eloisaglez/caelum/diseño/electrónica/circuit_image_pruebas.png

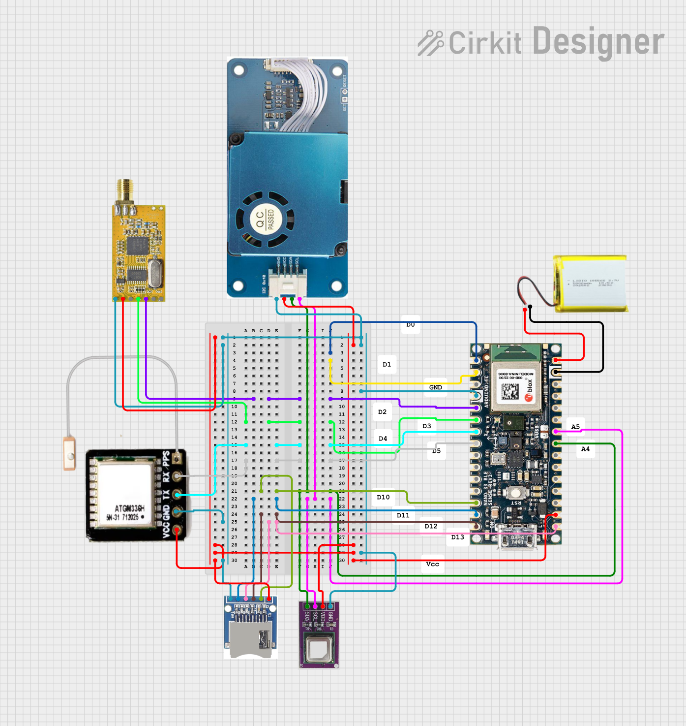
diseño/electrónica/circuit_image_pruebas.png
