eloisaglez/caelum/diseño/electrónica/circuit_image.png

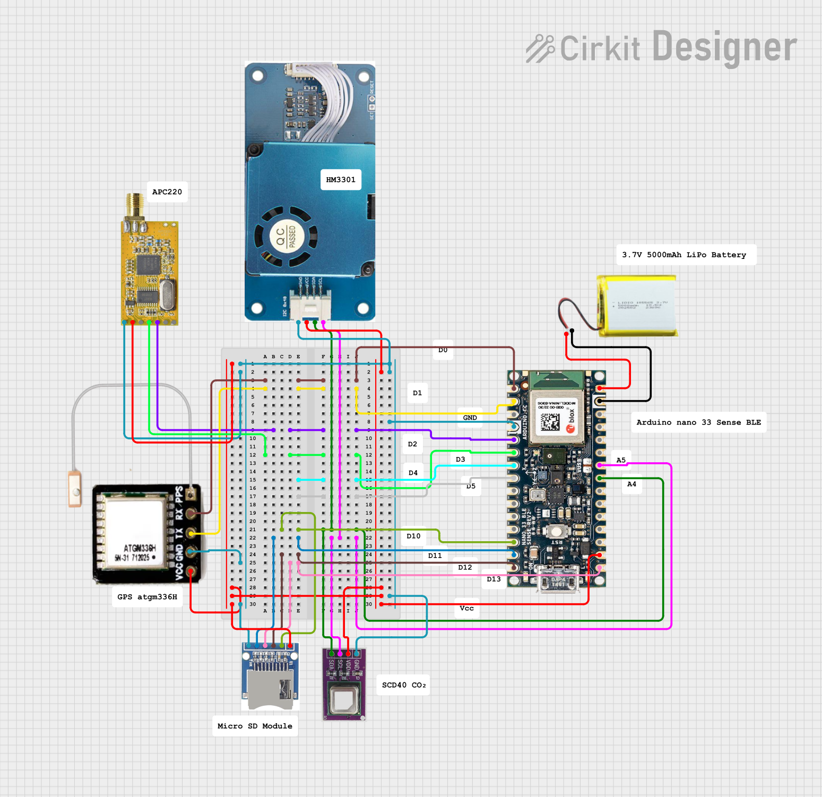
diseño/electrónica/circuit_image.png
