eloisaglez/caelum/README_main.md

# CanSat Misión 2 - Detección de Firmas de Combustión

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

---

## Descripción

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

---

## Características

| Componente | Descripción |
|---|---|
| **Microcontrolador** | Arduino Nano 33 BLE Sense Rev2 |
| **Sensor CO₂** | SCD40: CO₂ real (NDIR) + Temperatura + Humedad — trazador de estabilidad atmosférica |
| **Sensor Partículas** | HM3301: PM1.0, PM2.5, PM10 (láser) — perfil vertical e inversiones térmicas |
| **Temp/Humedad integrado** | HS300x + LPS22HB — validación cruzada triple de temperatura |
| **Posicionamiento** | GPS ATGM336H |
| **Almacenamiento** | MicroSD — CSV 27 columnas (respaldo local) |
| **Telemetría** | APC220: RF 434 MHz en tiempo real |
| **Panel Web** | Firebase + Telemetría en vivo |
| **Análisis** | Python: Perfiles verticales + Detección de inversiones + KML |

---

## Estructura del Repositorio

```
cansat-mision2/
│
├── design/                        
│   ├── structural/                  # Carcasa
│   ├── recovery/                    # Paracaídas
│   ├── electronics/                 # Circuitos
│   └── comms/                       # Antena
│
├── software/
│   ├── pruebas/                     # Programas individuales de cada sensor
│   │   ├── PROGRAMA_1_SENSORES_INTEGRADOS.ino
│   │   ├── PROGRAMA_2_SCD40_CO2.ino
│   │   ├── PROGRAMA_3_HM3301_PM25.ino
│   │   ├── PROGRAMA_4_GPS.ino
│   │   ├── PROGRAMA_5_MICROSD.ino
│   │   ├── PROGRAMA_6_APC220_CONFIG.ino
|   |   ├── PROGRAMA_7_GRABACION_RAM.ino
│   │   └── Otros
|   |
│   │
│   ├── vuelo/                       # Programa final + panel web
│   │   ├── CANSAT_VUELO_INTEGRADO.ino
│   │   └── panel_web/
│   │       ├── caelum_dashboard.html
│   │       ├── caelum_playback.py
│   │       └── receptor_telemetria.py
│   │
│   ├── post_vuelo/                  # Análisis después del vuelo
│   │   ├── analizar_vuelo.py
│   │   ├── generar_kml.py
│   │   ├── extraer_ram.py
│   │   ├── GUIA_POST_VUELO.md
│   │   ├── GUIA_RAPIDA_POST_VUELO.txt
│   │   └── README_post_vuelo.md
│   │
│   └── simulacion/                  # Simuladores pre-vuelo
│       ├── simulador_inversion_termica.py   # Escenario con inversión y PM2.5 alto
│       ├── simulador_sin_contaminacion.py   # Escenario limpio sin inversión
│       └── README_simulacion.md
│
├── documentation/
│   ├── pruebas/                     # Guías de cada sensor
│   │   ├── DOCUMENTO_1_SENSORES_INTEGRADOS.md
│   │   ├── DOCUMENTO_2_SCD40_CO2.md
│   │   ├── DOCUMENTO_3_HM3301_PM25.md
│   │   ├── DOCUMENTO_4_GPS.md
│   │   ├── DOCUMENTO_5_MICROSD.md
│   │   ├── DOCUMENTO_6_APC220_TELEMETRIA.md
│   │   └── DOCUMENTO_7_GRABACION_RAM.md
│   │
│   ├── vuelo/                       # Preparación del vuelo
│   │   ├── INDICE_DE_PRUEBAS_FINAL.md
│   │   ├── CHECKLIST_VUELO.md
│   │   └── IMPORTANTE_CAMBIO_FRECUENCIA.md
│   │
│   ├── troubleshooting/             # Solución de problemas
│   │   └── TROUBLESHOOTING_COMPLETO.md
│   │
│   └── INDEX.md
│
├── data/                            # Datos de vuelos; CSVs, Gráficas, mapas, KML 
│   ├── vuelos/                      
│   └── Simulación/                  # Datos generados con un Python 
│
└── README.md
```

---

## Inicio Rápido

### 1. Probar sensores integrados

```bash
1. Abrir: software/pruebas/PROGRAMA_1_SENSORES_INTEGRADOS.ino
2. Tools → Board → Arduino Nano 33 BLE
3. Ctrl+U para cargar
4. Monitor Serie a 9600 baud
```

### 2. Probar SCD40 (CO2)

```bash
1. Abrir: software/pruebas/PROGRAMA_2_SCD40_CO2.ino
2. Verificar conexión I2C (dirección 0x62)
3. Esperar 5 segundos para primera lectura
4. Monitor Serie: CO2 (ppm), Temp (°C), Humedad (%)
```

### 3. Probar HM3301 (PM2.5)

```bash
1. Abrir: software/pruebas/PROGRAMA_3_HM3301_PM25.ino
2. Verificar conexión I2C (dirección 0x40)
3. Esperar ~30 segundos para estabilización
4. Monitor Serie: PM1.0, PM2.5, PM10 (µg/m³)
```

### 4. Configurar telemetría APC220

```bash
1. Conectar APC220 a Arduino UNO (ver DOCUMENTO_6)
2. Cargar: software/pruebas/PROGRAMA_6_APC220_CONFIG.ino
3. En Monitor Serie escribir: WR 434000 3 9 3 0
4. Verificar con: RD
5. Repetir con el segundo APC220
```

### 5. Cargar programa final

```bash
1. Abrir: software/vuelo/CANSAT_VUELO_INTEGRADO.ino
2. Cargar en Arduino Nano 33 BLE
3. Verificar datos en receptor (USB-TTL + APC220)
```

### 6. Análisis post-vuelo

```bash
cd software/post_vuelo
pip install pandas numpy folium matplotlib
python limpiar_espera.py datos_SD_raw.csv   # Genera datos_SD.csv limpio
python analizar_vuelo.py datos_SD.csv
python generar_kml.py datos_SD.csv   # Genera trayectoria 3D para Google Earth
```

---

## Conexiones Hardware

### Arduino Nano 33 BLE Sense Rev2

```
Sensores Integrados:
├── HS300x:  Temperatura + Humedad               → temp_hs,  hum_hs  (sensor principal)
├── LPS22HB: Presión + Altitud + Temperatura     → presion, alt, temp_lps (validación T)
├── BMI270:  Acelerómetro + Giroscopio           → accel_x/y/z, gyro_x/y/z
└── BMM150:  Magnetómetro

Sensores Externos I2C (A4=SDA, A5=SCL):
├── SCD40 (0x62): CO₂ + Temperatura + Humedad   → co2, temp_scd, hum_scd (validación T+HR)
└── HM3301 (0x40): PM1.0, PM2.5, PM10           → pm1_0, pm2_5, pm10

Validación cruzada de temperatura: HS300x vs SCD40 vs LPS22HB
Validación cruzada de humedad:     HS300x vs SCD40

Comunicaciones:
├── Serial1 (Pin 0/1) → GPS ATGM336H
├── UART (Pin 2/3)    → APC220 (Telemetría)
└── SPI (D10-D13)     → MicroSD
```

### Pinout SCD40 (CO2)

```
VCC → 3.3V
GND → GND
SDA → Pin A4
SCL → Pin A5
```

### Pinout HM3301 (PM2.5)

```
VCC (rojo)     → 3.3V
GND (negro)    → GND
SDA (blanco)   → Pin A4
SCL (amarillo) → Pin A5
```

### Pinout GPS ATGM336H

```
TX GPS → Pin 0 (RX Serial1)
RX GPS → Pin 1 (TX Serial1)
VCC    → 3.3V
GND    → GND
```

### APC220 - Conexión Emisor (Nano 33 BLE)

```
TXD APC220 → Pin 2 (RX)
RXD APC220 → Pin 3 (TX)
VCC        → 3.3V
GND        → GND

Código: UART ApcSerial(3, 2);
```

### APC220 - Receptor en Tierra (USB-TTL)

```
USB-TTL     APC220
───────────────────
TX      →   TXD
RX      →   RXD
3.3V    →   VCC
GND     →   GND
```

---

## Interpretación de Datos

### CO₂ — Confirmación de sensor y atmósfera

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

### PM2.5 — Perfil vertical e inversiones térmicas (HM3301)

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

### Detección de inversiones térmicas

```
PATRÓN DE INVERSIÓN TÉRMICA (buscar en perfil vertical):
  Altitud ↑ + Temperatura ↑ (en vez de bajar) + PM2.5 ↑
                    ↓
       Capa de partículas atrapadas (no se dispersan)
                    ↓
       Al bajar la temperatura nocturna, la capa desciende
                    ↓
       Las partículas llegan a nivel del suelo
                    ↓
       Riesgo real: ataques de asma, alertas AQI en Madrid
```

### Validación cruzada de temperatura y humedad

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

---

## Firmas de Combustión Detectables

| Fuente | PM2.5 (µg/m³) | Patrón |
|---|---|---|
| **Aire limpio** | 0–12 | Constante y bajo |
| **Tráfico / zona urbana** | 12–55 | Aumenta en capas bajas |
| **Industria / incendio** | >55 | Picos en capas concretas |
| **Polvo (sin combustión)** | 50–150 | Solo PM alto, CO₂ constante |

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

```
CO₂ CONSTANTE + PM2.5 BAJO  → Aire limpio ✓
CO₂ CONSTANTE + PM2.5 ALTO  → Polvo o tráfico sin inversión
CO₂ VARIABLE  + PM2.5 ALTO  → Inversión térmica atrapando gases y partículas
CO₂ VARIABLE  + PM2.5 BAJO  → Capas diferenciadas sin fuente local

Nota: A ~1000m el CO₂ es siempre ~420 ppm. Lo relevante es si VARÍA con la altitud.
```

---

## Documentación

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

---

## Panel Web

Panel de telemetría en tiempo real conectado a Firebase.

**URL:** https://cansat-66d98.web.app

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

---

## Análisis Post-Vuelo

Scripts Python para analizar los datos después del vuelo.

**Ubicación:** `software/post_vuelo/`

**Fuentes de datos aceptadas:**

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

---

## Checklist Pre-Vuelo

```
[ ] Arduino inicializa correctamente
[ ] Todos los sensores responden:
    [ ] HS300x   (Temp/Hum integrado — valores coherentes con ambiente)
    [ ] LPS22HB  (Presión/Altitud/Temp integrado — altitud relativa = 0 m en tierra)
    [ ] BMI270/BMM150 (IMU integrado)
    [ ] SCD40    (CO₂ = 410–430 ppm en exterior — confirma mezcla correcta)
    [ ] HM3301   (PM2.5 < 35 µg/m³ en aire limpio)
[ ] Validación cruzada T+HR: DeltaT < 2 °C entre HS300x, SCD40 y LPS22HB
[ ] APC220 configurados (ambos: WR 434000 3 9 3 0)
[ ] GPS obtiene fix (4+ satélites)
[ ] MicroSD formateada (FAT32) y montada — CSV con 27 columnas
[ ] Batería cargada
[ ] Antenas conectadas en ambos APC220
[ ] Receptor en tierra funcionando
[ ] Panel web Firebase accesible
```

---

## Checklist Día del Concurso

```
[ ] Cambiar frecuencia APC220 según organización
[ ] Verificar comunicación emisor-receptor a distancia
[ ] Cargar CANSAT_VUELO_INTEGRADO.ino
[ ] Probar todos los sensores (valores baseline)
[ ] Verificar GPS en ubicación de lanzamiento
[ ] Comprobar que datos llegan a Firebase
[ ] ¡A volar!
```

---

## Librerías Necesarias

### Arduino IDE

**Sensores integrados:**
- Arduino_BMI270_BMM150 (IMU)
- Arduino_HS300x (Temperatura/Humedad)
- ReefwingLPS22HB (Presión/Altitud)

**Sensores externos:**
- SensirionI2CScd4x (SCD40 - CO2)
- Seeed_HM330X (HM3301 - PM2.5)

**Otros:**
- TinyGPSPlus (GPS)
- SD (MicroSD)

### Python

```bash
pip install pandas numpy folium matplotlib simplekml requests
```

---

## Troubleshooting Rápido

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

Ver: [TROUBLESHOOTING_COMPLETO.md](documentation/troubleshooting/TROUBLESHOOTING_COMPLETO.md)

---

## Notas Importantes

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

**MicroSD:**
- Solo 3.3V (NUNCA 5V)
- Formatear FAT32
- Máximo 32GB recomendado

**GPS:**
- Necesita cielo abierto
- Tiempo primera fix: 2-5 minutos

---

## Créditos

**IES Diego Velázquez**  
Departamento de Tecnología  
Torrelodones, Madrid, España

**Proyecto:** CanSat Misión 2 - Detección de Firmas de Combustión  
**Programa:** Erasmus+ STEMadrid Network  
**Fecha:** Febrero 2026

---

## Licencia

Uso educativo - IES Diego Velázquez

Este proyecto se desarrolla con fines educativos dentro del programa Erasmus+ y la red STEMadrid.

---

*Hecho con ❤️ para educación STEAM*

**#CanSat #STEAM #Arduino #AirQuality #CO2 #PM25**
