eloisaglez/caelum/documentacion/post-vuelo/GUIA_POST_VUELO.md

# GUÍA POST-VUELO — CanSat CAELUM
**IES Diego Velázquez · Misión 2 · Detección de Firmas de Combustión**

---

## Resumen del Sistema de Datos

El CanSat guarda los datos en **dos lugares simultáneamente**:

| Fuente | Dónde | Cuándo usar |
|---|---|---|
| **MicroSD** | Tarjeta SD dentro del CanSat | **Siempre** — fuente principal |
| **RAM backup** | Memoria interna del Arduino | Si la SD falla — fuente de emergencia |

> ⚠️ La RAM backup se pierde si se apaga el Arduino. La SD card conserva los datos aunque la batería se agote.

---

## 1. Recuperación del CanSat

### Pasos inmediatos al encontrarlo:

1. **No apagar el Arduino** — la RAM backup sigue activa
2. Comprobar que la batería tiene carga (LED verde encendido)
3. Llevar el portátil al lugar de recuperación si es posible
4. Si la batería está muy baja, **extraer la SD card primero**

---

## 2. Extraer Datos de la SD Card (Fuente Principal)

### Material necesario:
- Lector de tarjetas MicroSD (o adaptador SD)
- Ordenador

### Pasos:

1. **Apagar el CanSat** con seguridad (esperar a que el LED se apague)
2. **Extraer la MicroSD** del módulo Adafruit
3. **Insertar** en el lector de tarjetas del ordenador
4. Buscar el archivo **`VUELO.CSV`** en la raíz de la tarjeta
5. **Copiar** `VUELO.CSV` a tu ordenador
6. Renombrar para identificar el vuelo:
   ```
   VUELO.CSV → vuelo_brunete_17marzo.csv   (ejemplo)
   ```

### Verificar que el CSV es correcto:

Abrir en Excel o Google Sheets y comprobar:
- ✅ Primera fila es la cabecera con 25 columnas
- ✅ Los números tienen sentido (altitud entre 0–1100 m, CO₂ entre 400–600 ppm)
- ✅ El timestamp aumenta progresivamente
- ✅ La columna `fase` pasa por: `espera → caida_libre → apertura → descenso → tierra`

**Cabecera esperada (25 columnas):**
```
timestamp, datetime, lat, lon, alt, alt_mar, sats,
temp_hs, hum_hs, temp_scd, hum_scd, temp_lps, presion,
co2, pm1_0, pm2_5, pm10,
accel_x, accel_y, accel_z, gyro_x, gyro_y, gyro_z, fase
```

---

## 3. Extraer RAM Backup (Solo si la SD Falló)

Si `VUELO.CSV` no existe o está vacío, usar el backup de RAM.

### Material necesario:
- Cable USB
- Ordenador con Arduino IDE o PuTTY

### Pasos:

1. **Conectar** el CanSat al ordenador por USB (**sin apagarlo**)
2. **Abrir Arduino IDE** → Herramientas → Monitor Serie
3. **Configurar** a 115200 baud
4. **Escribir** `CSV_RAM` y pulsar Enter

   El Arduino responderá con algo así:
   ```
   --- CSV RAM: inicio ---
   t_ms,alt_m,co2_ppm,pm25,temp_hs,hum_hs,temp_scd,hum_scd,temp_lps,acX,acY,acZ,fase
   1000,950.2,421,6.1,5.8,68.2,5.9,67.0,6.2,0.02,-0.01,9.81,caida_libre
   2000,932.5,422,5.8,5.9,68.0,6.0,66.8,6.3,...
   ...
   --- FIN: 185 registros ---
   ```

5. **Seleccionar** todo el texto (desde la cabecera hasta `FIN`)
6. **Copiar** (Ctrl+C)
7. **Abrir Bloc de notas**, pegar y guardar como `vuelo_ram.csv`

> ⚠️ La RAM guarda ~350 muestras a 2 segundos/muestra (~11 min). Menos resolución que la SD (1 muestra/segundo) pero suficiente para el análisis científico.

> Para limpiar la RAM tras exportar: escribir `BORRAR_RAM` en el Monitor Serie.

---

## 4. Análisis de Datos

### Instalación de dependencias (solo la primera vez):

```bash
pip install pandas numpy folium matplotlib
```

### Preparar el entorno:

```bash
# Copiar el CSV a la carpeta del script
cp vuelo_brunete_17marzo.csv software/post_vuelo/python/

# Ir a la carpeta
cd software/post_vuelo/python/
```

### Ejecutar el análisis:

```bash
python analizar_vuelo_v4.py vuelo_brunete_17marzo.csv
```

El script genera automáticamente la carpeta `analisis_vuelo/` con:

```
analisis_vuelo/
├── graf_1_perfil_vertical.png      → Perfiles PM + CO₂ + temperatura por altitud
├── graf_2_inversiones_termicas.png → Detección de capas e inversiones
├── graf_3_validacion_cruzada.png   → Comparativa de los 3 sensores de temperatura
├── graf_4_mision_primaria.png      → Altitud, presión, velocidad, trayectoria GPS
├── mapa_vuelo.html                 → Mapa interactivo con trayectoria y PM2.5
└── informe_vuelo.txt               → Resumen estadístico completo
```

---

## 5. Reproducir el Vuelo en el Panel Web

Para ver los datos en el dashboard en tiempo real (modo replay):

1. Subir `caelum_datos_vuelo.csv` a Google Colab
2. Ejecutar `caelum_playback.py`
3. Abrir el dashboard: https://cansat-66d98.web.app
4. Seleccionar **REPLAY VUELO**

```bash
# En Colab o local
python caelum_playback.py caelum_datos_vuelo.csv
```

---

## 6. Interpretación de Resultados

### CO₂ — Trazador de estabilidad atmosférica

> El CO₂ a 1000 m **no indica calidad del aire** — indica si la atmósfera está bien mezclada.

| CO₂ vs Altitud | Interpretación |
|---|---|
| ~420 ppm constante en todo el perfil | ✅ Atmósfera bien mezclada — normal |
| Aumenta gradualmente al bajar | Fuentes de combustión en superficie (tráfico) |
| Pico en una altitud concreta | Posible capa de inversión atrapando gases |
| Variación > 20 ppm entre altitudes | Capas atmosféricas diferenciadas detectadas |

---

### PM2.5 — Perfil vertical e inversiones térmicas

| PM2.5 (µg/m³) | Calidad OMS | Causa probable |
|---|---|---|
| 0–12 | 🟢 Excelente | Aire limpio |
| 12–35 | 🟢 Buena | Zona urbana normal |
| 35–55 | 🟡 Moderada | Tráfico moderado |
| 55–150 | 🟠 Mala | Tráfico intenso, industria |
| >150 | 🔴 Muy Mala | Humo, incendio cercano |

**Patrón de inversión térmica** (buscar en `graf_2_inversiones_termicas.png`):
```
Altitud ↑ + Temperatura ↑ (en vez de bajar) + PM2.5 ↑
              ↓
  Capa de partículas atrapadas
              ↓
  Al bajar la temperatura nocturna, la capa desciende a nivel del suelo
              ↓
  Riesgo real: alertas AQI, ataques de asma en Madrid
```

---

### Validación cruzada de temperatura (graf_3)

Tres sensores miden temperatura de forma independiente:

| Sensor | Variable | Comportamiento esperado |
|---|---|---|
| HS300x | `temp_hs` | Referencia principal |
| SCD40 | `temp_scd` | Diferencia < 1 °C respecto a HS300x |
| LPS22HB | `temp_lps` | Puede leer +0.3–0.5 °C más por calor del procesador |

- **ΔT < 2 °C** entre HS300x y SCD40 → sensores funcionando correctamente
- **ΔT > 3 °C** → posible fallo de sensor o gradiente térmico real en el CanSat

---

### Firmas de combustión combinadas

```
CO₂ ALTO + PM2.5 ALTO  → Combustión activa (motor, fuego)
CO₂ ALTO + PM2.5 BAJO  → Fermentación/respiración (raro en exterior)
CO₂ BAJO + PM2.5 ALTO  → Polvo sin combustión (obra, viento)
CO₂ BAJO + PM2.5 BAJO  → Aire limpio ✓
```

---

## 7. Solución de Problemas

| Problema | Causa probable | Solución |
|---|---|---|
| `VUELO.CSV` no existe | SD no se inicializó | Usar RAM backup (`CSV_RAM`) |
| CSV con menos de 25 columnas | Versión antigua del firmware | Verificar que subiste `CANSAT_VUELO_INTEGRADO.ino` actualizado |
| CO₂ = 0 en todas las filas | SCD40 no respondió | Normal si el sensor tardó en calentarse. Las primeras 5s son 0 |
| GPS lat/lon = 0 | Sin fix GPS | Normal si el vuelo fue sin cielo despejado. Las gráficas funcionan sin GPS |
| `temp_lps` siempre ~0.5°C más alta | Calor del procesador | Normal y esperado — no es un error |
| ΔT > 3°C entre HS300x y SCD40 | Fallo de sensor o condensación | Revisar conexiones I2C del SCD40 |
| PM2.5 = 0 durante todo el vuelo | HM3301 no respondió | Verificar conexión I2C (0x40) y alimentación 3.3V |
| `analizar_vuelo_v4.py` da error | Columnas incorrectas | Verificar cabecera del CSV con Excel |

---

## 8. Comandos del CanSat (Monitor Serie a 115200 baud)

| Comando | Función |
|---|---|
| `CSV_RAM` | Exporta todos los datos guardados en RAM en formato CSV |
| `BORRAR_RAM` | Limpia la memoria RAM (hacer DESPUÉS de exportar) |

> La SD card se gestiona automáticamente — no necesita comandos.

---

## 9. Checklist Post-Vuelo

```
[ ] CanSat localizado y recuperado
[ ] Batería comprobada (LED verde)
[ ] Arduino NO apagado hasta exportar RAM si es necesario
[ ] SD card extraída
[ ] VUELO.CSV copiado al ordenador
[ ] VUELO.CSV verificado en Excel (25 columnas, datos coherentes)
[ ] Si SD vacía: RAM exportada con CSV_RAM y guardada
[ ] Script analizar_vuelo_v4.py ejecutado correctamente
[ ] graf_1_perfil_vertical.png revisada (¿hay capas de PM2.5?)
[ ] graf_2_inversiones_termicas.png revisada (¿hay inversión térmica?)
[ ] graf_3_validacion_cruzada.png revisada (ΔT < 2°C entre sensores)
[ ] mapa_vuelo.html abierto y trayectoria verificada
[ ] informe_vuelo.txt leído y guardado
[ ] Datos subidos a Firebase con caelum_playback.py (opcional)
[ ] Dashboard verificado en https://cansat-66d98.web.app
```

---

**Equipo:** CAELUM
**Centro:** IES Diego Velázquez
**Proyecto:** CanSat Misión 2 — Detección de Firmas de Combustión
**Fecha:** Febrero 2026
