eloisaglez/caelum/documentacion/Proyecto_Caelum_Guia_Completa_v2.docx

# PROYECTO CAELUM

Sistema de Telemetría GPS en Tiempo Real

Caelum - Del latín: Cielo, Firmamento

⚠️ NOTA IMPORTANTE — Documento de referencia histórica

Este documento describe la arquitectura inicial del proyecto (enero 2026), basada en Arduino Uno + GPS independiente. El sistema actual usa Arduino Nano 33 BLE Sense Rev2 con sensores SCD40, HM3301, LPS22HB, HS300x y GPS integrado.

Válido como referencia SOLO para la configuración de Firebase (Paso 1). Para la documentación técnica completa del sistema actual, consultar PRUEBAS_PROBLEMAS_SOLUCIONES_Arduino_Nano_33_BLE_Sense.md

## 📋 Introducción

Este documento contiene todos los pasos necesarios para configurar el sistema de telemetría en tiempo real del Proyecto Caelum. El sistema transmite datos GPS por radio APC220 y los visualiza en un panel web mediante Firebase Realtime Database.

## 🏗️ Arquitectura del Sistema

1. Caelum (Arduino + GPS ATGM336H + APC220)

Lee datos GPS y los transmite por radio

2. Estación Base (Arduino + APC220)

Recibe datos de Caelum y los reenvía al PC por USB

3. Script Python

Lee datos del puerto serie y los sube a Firebase

4. Firebase Realtime Database

Almacena y sincroniza datos en tiempo real

5. Panel Web (HTML + JavaScript)

Muestra datos en tiempo real: mapa, altitud, coordenadas, etc.

## 🔧 Hardware Necesario

### Para Caelum (Sonda)

- Arduino Uno (o compatible)
- GPS ATGM336H
- Módulo radio APC220 (transmisor)
- Alimentador 9V externo (IMPORTANTE: el GPS consume mucha corriente)
- Cables de conexión

### Para la Estación Base

- Arduino Uno
- Módulo radio APC220 (receptor)
- Cable USB para conexión al PC

## 🔥 Paso 1: Configuración de Firebase

6. Crear proyecto Firebase
- Ve a: https://console.firebase.google.com/
- Haz clic en 'Agregar proyecto'
- Nombre del proyecto: 'Caelum' (o el que prefieras)
- Desactiva Google Analytics (no es necesario)
- Haz clic en 'Crear proyecto'
7. Crear Realtime Database
- En el menú lateral: 'Realtime Database'
- Haz clic en 'Crear base de datos'
- Ubicación: 'europe-west1' (más cercana a España)
- Modo: 'Comenzar en modo de prueba' (temporal para desarrollo)
8. Obtener credenciales para Python
- Ve a: Configuración del proyecto (⚙️) → Cuentas de servicio
- Haz clic en 'Generar nueva clave privada'
- Se descarga 'serviceAccountKey.json' → Guárdalo en carpeta del proyecto
- ⚠️ IMPORTANTE: No subas este archivo a GitHub (es confidencial)
9. Obtener configuración Web
- Ve a: Configuración del proyecto → General
- En 'Tus aplicaciones' → Web (ícono </>) → Registrar app
- Nombre: 'Panel Caelum'
- Copia la configuración firebaseConfig (la necesitarás para el panel web)

## 💻 Paso 2: Código Arduino Caelum (Transmisor)

### Conexiones Hardware

Módulo | Pin Módulo | Pin Arduino
GPS ATGM336H | TX | Pin 4 (RX SoftwareSerial)
| RX | Pin 3 (TX SoftwareSerial)
| VCC | 5V
| GND | GND
APC220 | TXD | Pin 10 (RX SoftwareSerial)
| RXD | Pin 11 (TX SoftwareSerial)
| VCC | 5V
| GND | GND

### Código Arduino

Archivo: caelum_transmisor.ino

#include <TinyGPSPlus.h>
#include <SoftwareSerial.h>

// GPS
SoftwareSerial gpsSerial(4, 3);
TinyGPSPlus gps;

// APC220
SoftwareSerial radioSerial(10, 11);

void setup() {
gpsSerial.begin(9600);
radioSerial.begin(9600);
}

void loop() {
while (gpsSerial.available() > 0) {
if (gps.encode(gpsSerial.read())) {
if (gps.location.isUpdated()) {
radioSerial.print(gps.location.lat(), 6);
radioSerial.print(",");
radioSerial.print(gps.location.lng(), 6);
radioSerial.print(",");
radioSerial.print(gps.altitude.meters(), 1);
radioSerial.print(",");
radioSerial.println(gps.satellites.value());
}
}
}
delay(1000);
}

## 🐍 Paso 3: Script Python

Opción A: Simulador (para pruebas)

Archivo: caelum_simulador.py

Simula un lanzamiento completo con subida, caída y aterrizaje. Útil para probar Firebase y el panel web sin hardware.

Opción B: Conexión real (con Arduino)

Archivo: caelum_to_firebase.py

Lee datos del puerto serie del Arduino y los sube a Firebase.

⚠️ Instalación de librerías:

pip install pyserial firebase-admin

⚠️ Configuración necesaria:

- Coloca 'serviceAccountKey.json' en la misma carpeta
- Cambia 'TU-PROYECTO' por tu ID de Firebase
- En caelum_to_firebase.py: cambia 'COM5' por tu puerto

## 🌐 Paso 4: Panel Web

Archivo: caelum_panel.html

⚠️ IMPORTANTE: Configurar Firebase

Busca esta sección en caelum_panel.html y reemplaza con tus datos de Firebase:

const firebaseConfig = {
apiKey: "TU_API_KEY",
authDomain: "TU_PROYECTO.firebaseapp.com",
databaseURL: "https://TU_PROYECTO.firebaseio.com",
projectId: "TU_PROYECTO",
...
};

Características del panel:

- 🌌 Diseño personalizado Caelum con gradientes morados
- 🗺️ Mapa en tiempo real con trayectoria
- 📊 Tarjetas con datos: latitud, longitud, altitud, satélites
- ✅ Indicador de conexión en tiempo real
- ⚡ Actualización automática

## 🚀 Paso 5: Uso del Sistema

### Con Simulador (Pruebas)

10. Ejecuta el simulador:

python caelum_simulador.py

11. Abre caelum_panel.html en tu navegador
12. Verás la simulación del lanzamiento en tiempo real

### Con Hardware Real

13. Enciende Estación Base (Arduino + APC220 conectado a PC)
14. Ejecuta el script Python:

python caelum_to_firebase.py

15. Abre caelum_panel.html en tu navegador
16. Enciende Caelum (Arduino + GPS + APC220 con alimentador 9V)
17. Coloca Caelum AL AIRE LIBRE
18. Espera 1-3 minutos hasta que obtenga fix GPS
19. Verás los datos en el panel web

─────────────────────────────────────

Proyecto Caelum - Enero 2026

IES Diego Velázquez - Torrelodones, Madrid
