eloisaglez/caelum/software/vuelo/panel_web/SEGURIDAD_FIREBASE.md

# 🔒 SEGURIDAD FIREBASE - Guía de Acción

## ⚠️ PROBLEMA DETECTADO

GitHub detectó tu API Key de Firebase expuesta en el repositorio público.

```
Alerta: Google API Key exposed in caelum_dashboard.html
```

---

## ✅ ACCIONES INMEDIATAS

### 1. **NO ENTRAR EN PÁNICO**

Para aplicaciones web educativas con Firebase **ES NORMAL** que la API Key sea pública.

**¿Por qué?**
- Firebase está diseñado para que la API Key esté en el frontend
- La seguridad real se controla con las **Reglas de Seguridad**
- No es como una contraseña de base de datos tradicional

---

### 2. **VERIFICAR TUS REGLAS DE SEGURIDAD**

Ve a Firebase Console:
```
https://console.firebase.google.com/project/cansat-66d98/database/rules
```

**Verifica que tengas algo así:**

```json
{
  "rules": {
    "cansat": {
      "telemetria": {
        ".read": true,    // ✅ Permitir lectura pública
        ".write": true,   // ⚠️ Permitir escritura pública (solo para educación)
        ".indexOn": ["timestamp"]
      }
    }
  }
}
```

---

### 3. **OPCIONES DE SEGURIDAD**

#### **Opción A: Dejar como está (Recomendado para educación)**

Si tu proyecto es educativo y no contiene datos sensibles:
- ✅ API Key pública está OK
- ✅ Reglas públicas están OK
- ✅ No hacer nada

**Justificación:**
- Es un CanSat educativo
- Los datos son telemetría pública
- Facilita que otros estudiantes lo usen

---

#### **Opción B: Restricciones básicas**

Agregar límites de escritura:

```json
{
  "rules": {
    "cansat": {
      "telemetria": {
        ".read": true,
        ".write": "auth != null || request.time < timestamp('2026-06-01')",
        // Permite escritura hasta junio 2026 (fin del proyecto)
      }
    }
  }
}
```

---

#### **Opción C: Rotar API Key (Nuclear)**

**⚠️ SOLO si detectas uso malicioso**

1. Firebase Console → Project Settings → General
2. Sección "Web API Key"
3. Clic en "Regenerate"
4. Actualizar el HTML con la nueva key
5. Hacer nuevo commit

**Consecuencia:**
- Panel web actual dejará de funcionar
- Necesitarás actualizar todos los archivos

---

### 4. **SILENCIAR LA ALERTA DE GITHUB**

Si decides que es seguro (opción A), puedes:

1. Ir al repositorio en GitHub
2. Clic en la alerta de "Security"
3. Clic en "Dismiss alert"
4. Seleccionar: "Used in tests" o "Won't fix"

**Mensaje para GitHub:**
```
This is a Firebase web API key for an educational project.
The database is protected by Firebase Security Rules.
Public API keys are standard for Firebase web apps.
```

---

## 📝 ACTUALIZAR .gitignore

Añade esto a tu `.gitignore`:

```gitignore
# Firebase privado (NO subir)
serviceAccountKey.json
firebase-config.js

# Permitido (API Key pública)
# cansat_gold_firebase.html  # ← NO ignorar, es correcto

# Node modules si usas npm
node_modules/
.firebase/
firebase-debug.log
```

---

## ✅ LO QUE YA HICIMOS

1. ✅ **Reemplazamos simulador_completo.py**
   - Ahora usa REST API
   - **NO necesita serviceAccountKey.json**
   - Más seguro para GitHub

2. ✅ **Panel web**
   - API Key pública es correcta
   - Está protegida por reglas Firebase

---

## 🎯 RECOMENDACIÓN FINAL

Para tu proyecto educativo CanSat:

**OPCIÓN A: NO HACER NADA** ✅

**Razones:**
1. Es una aplicación web pública
2. Los datos son telemetría no sensible
3. Firebase está diseñado así
4. Facilita la colaboración educativa
5. Otros estudiantes pueden probar el proyecto

**Solo actúa si:**
- ❌ Detectas escrituras sospechosas en Firebase
- ❌ Tu base de datos crece sin razón
- ❌ Ves datos que no enviaste tú

---

## 📚 REFERENCIAS

- [Firebase Security Rules](https://firebase.google.com/docs/rules)
- [Firebase Web Setup](https://firebase.google.com/docs/web/setup)
- [Is it safe to expose Firebase apiKey?](https://stackoverflow.com/questions/37482366/)

**Respuesta oficial de Firebase:**
> "Unlike how API keys are typically used, API keys for Firebase services 
> are not used to control access to backend resources; that can only be done 
> with Firebase Security Rules."

---

## ✉️ RESPONDER A GITHUB

Si quieres cerrar la alerta, puedes responder:

```
Este proyecto educativo usa Firebase Realtime Database con API Key pública.
La seguridad está controlada por Firebase Security Rules.
No hay información sensible expuesta.

Proyecto: CanSat Misión 2 - IES Diego Velázquez
Tipo: Educativo - Competición CanSat
Datos: Telemetría pública de satélite educativo
```

---

## 🎓 CONCLUSIÓN

**Para tu CanSat:**
- ✅ API Key pública es CORRECTO
- ✅ No necesitas rotarla
- ✅ Es seguro subirlo a GitHub
- ✅ Firebase está diseñado así

**¡Tu proyecto está BIEN!** 🚀
