eloisaglez/caelum/data/simulacion/graf_1_perfil_vertical.png

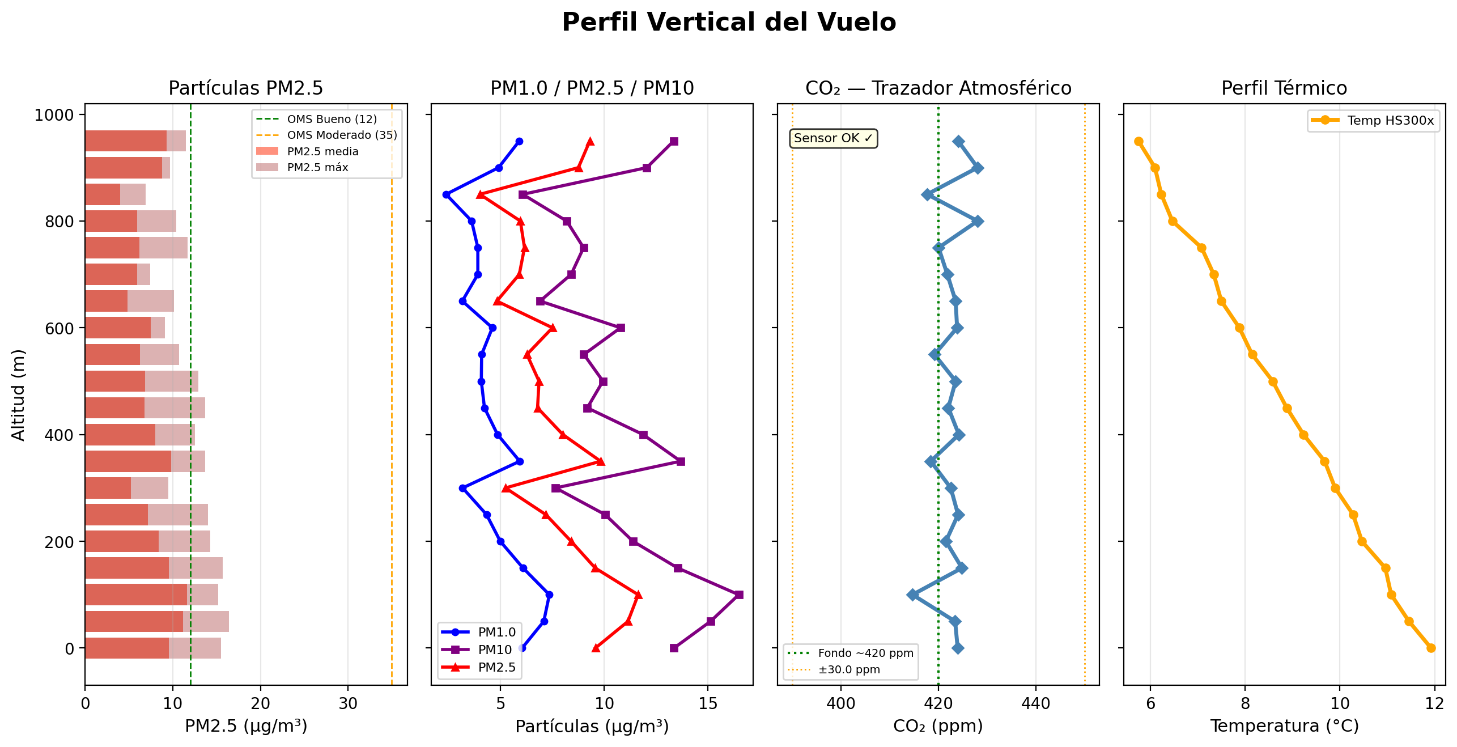
data/simulacion/graf_1_perfil_vertical.png
