eloisaglez/caelum/data/simulacion/graf_2_inversiones_termicas.png

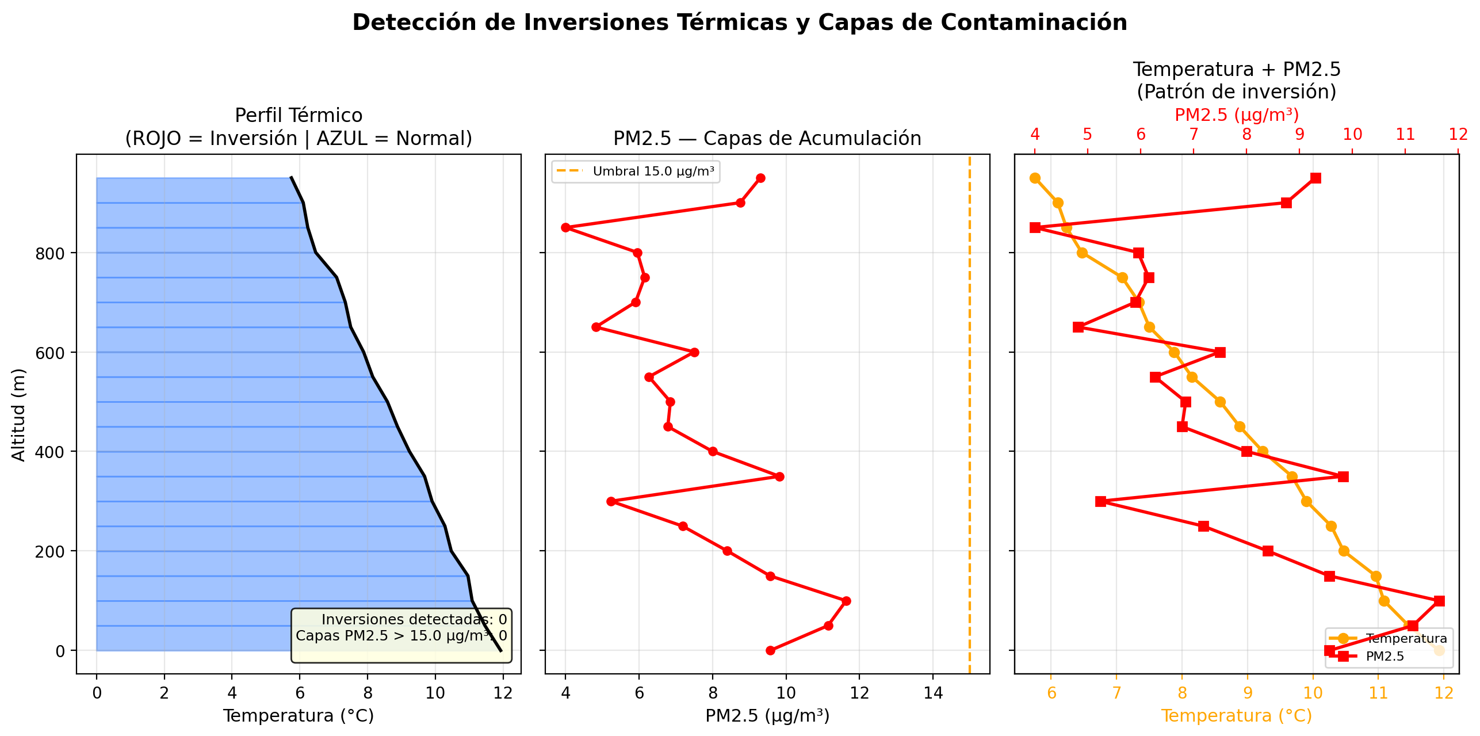
data/simulacion/graf_2_inversiones_termicas.png
