eloisaglez/caelum/data/simulacion/graf_3_validacion_cruzada.png

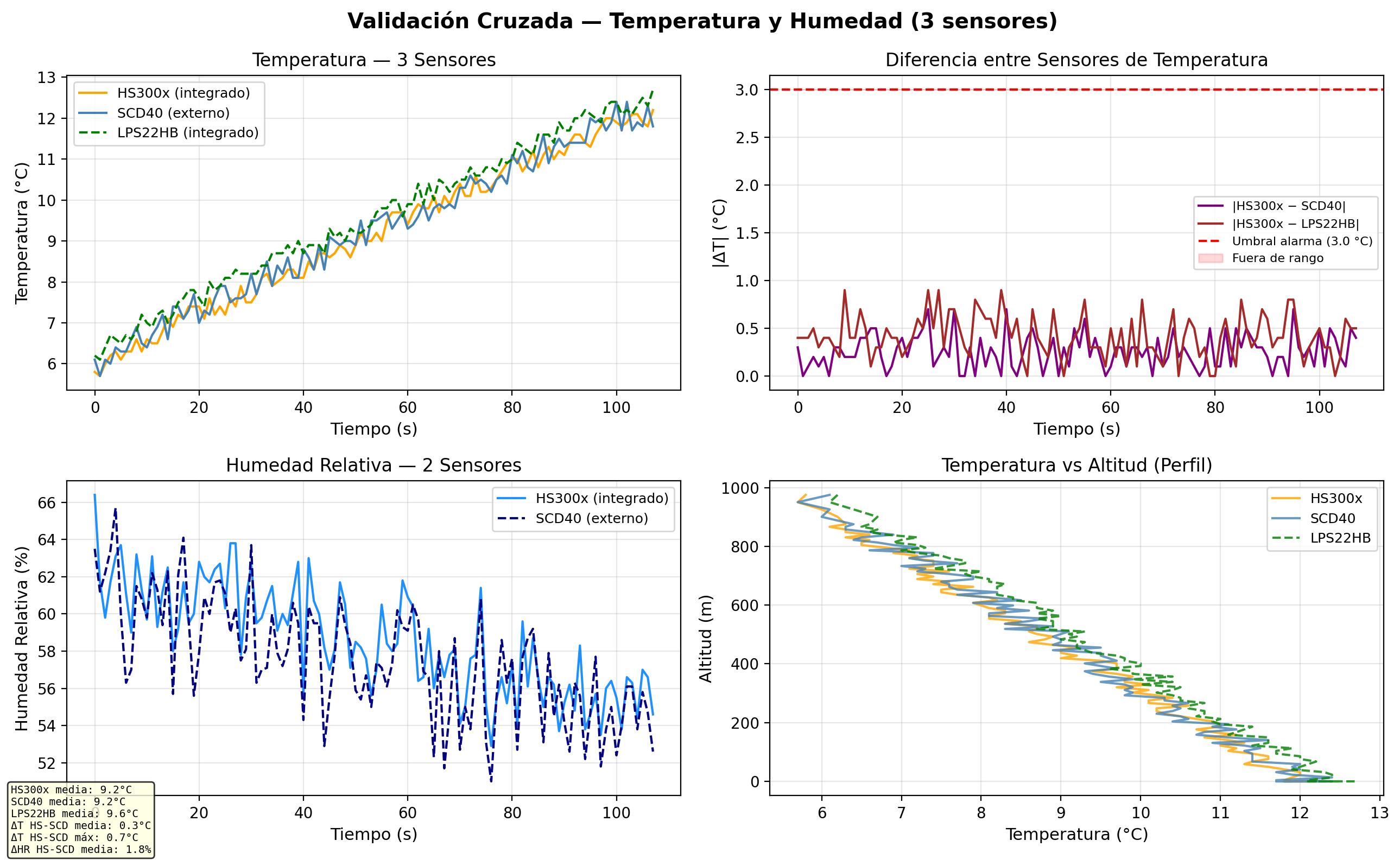
data/simulacion/graf_3_validacion_cruzada.png
