eloisaglez/caelum/data/simulacion/graf_4_mision_primaria.png

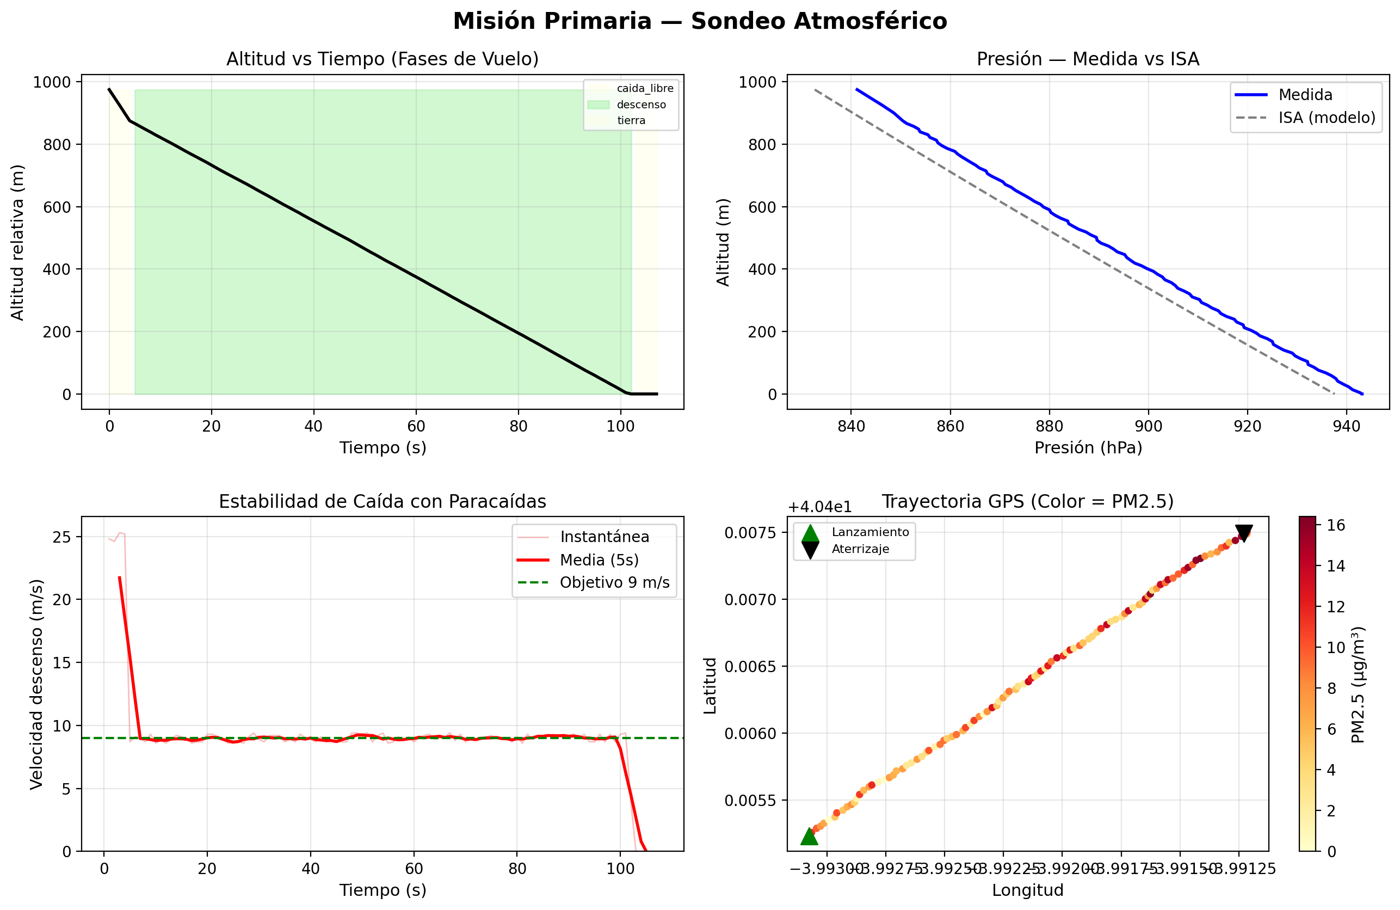
data/simulacion/graf_4_mision_primaria.png
