eloisaglez/caelum/data/simulacion/graficas_mision_primaria(1).png

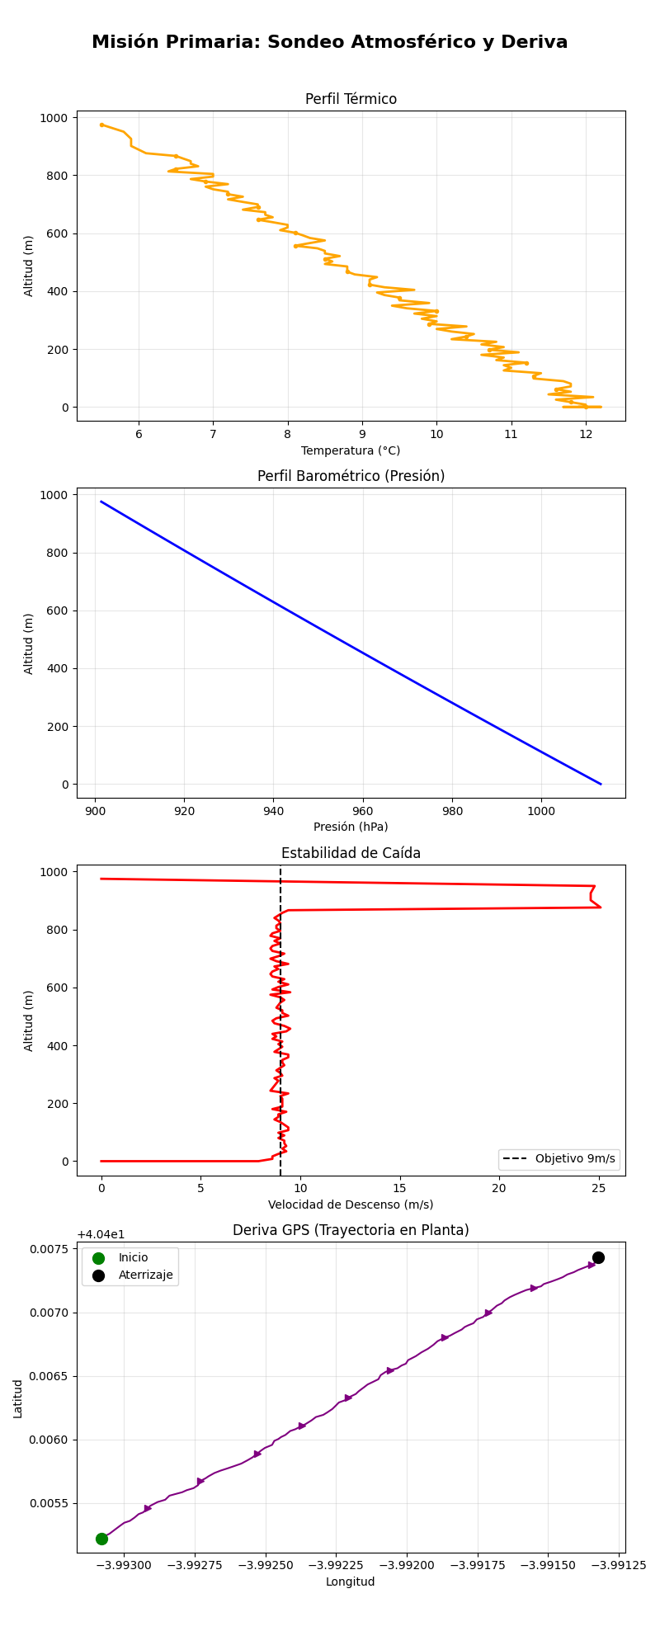
data/simulacion/graficas_mision_primaria(1).png
