eloisaglez/caelum/data/simulacion/graficas_mision_secundaria(2).png

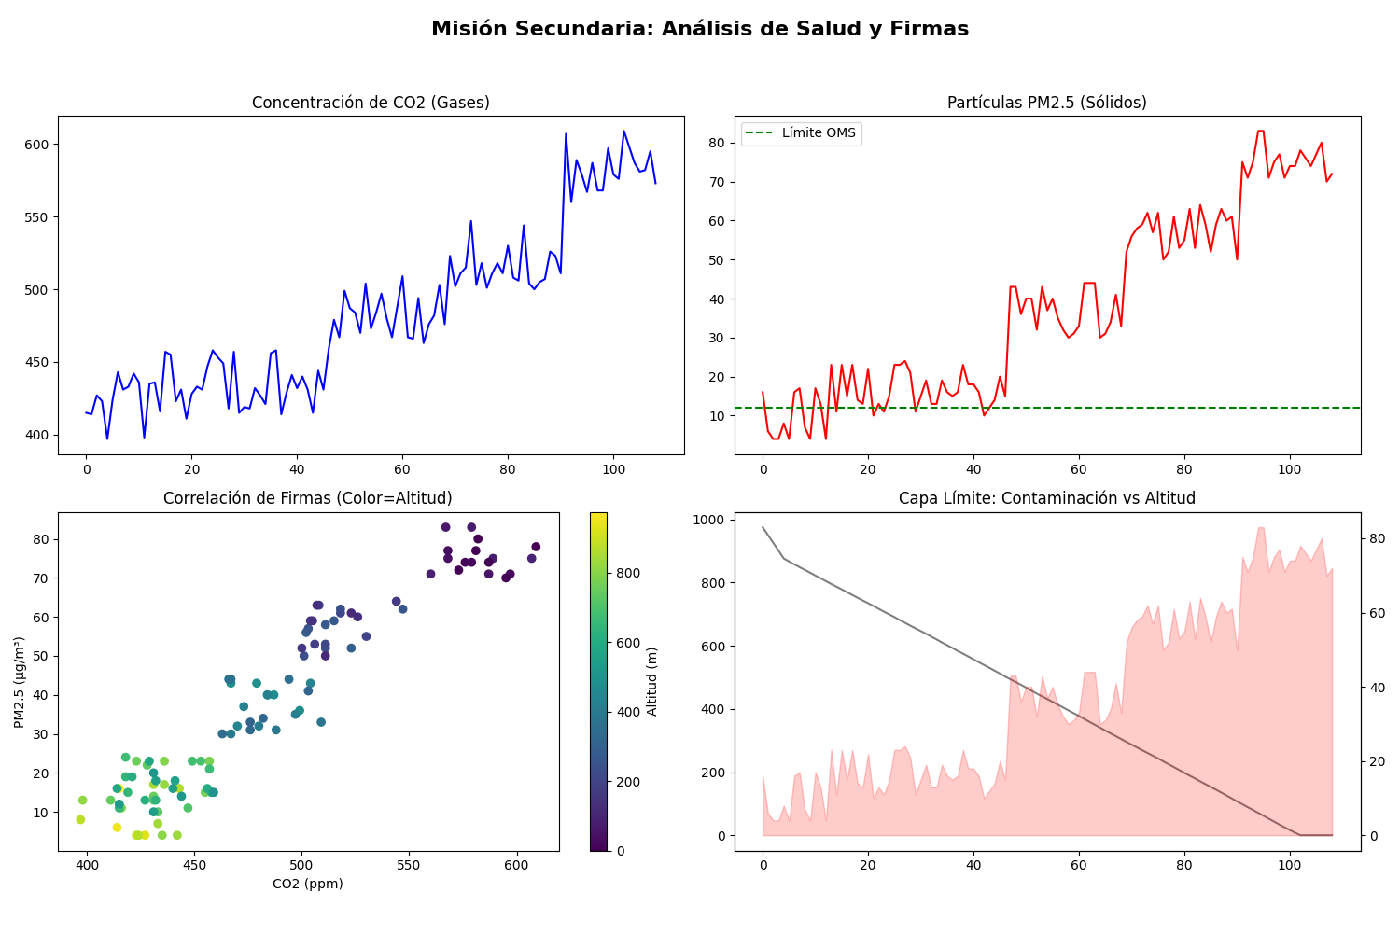
data/simulacion/graficas_mision_secundaria(2).png
