eloisaglez/caelum/documentacion/pruebas/DOCUMENTO_5_APC220_TELEMETRIA.md

# GUÍA RÁPIDA - CONFIGURACIÓN Y USO APC220

## Objetivo
Configurar y usar **DOS módulos APC220** para telemetría del CanSat (emisor + receptor).

---

## CRÍTICO: AMBOS DEBEN TENER LA MISMA CONFIGURACIÓN

Si no coinciden → NO se comunican  
Si coinciden → Listos para CanSat

---

## CONFIGURACIÓN OBJETIVO (AMBOS)

```
Frecuencia:     434 MHz (434000 KHz)
Velocidad RF:   9600 bps
Potencia:       9 (máxima)
Puerto serie:   9600 bps
Paridad:        0 (sin paridad)

Comando: WR 434000 3 9 3 0
```

---

## PARTE 1: CONFIGURAR LOS APC220

### Método: Arduino UNO como configurador

Otros métodos (rfmagic, PuTTY, terminales serie) no funcionaron porque no podían establecer comunicación con el módulo.

### Hardware necesario
- Arduino UNO
- Módulo APC220
- Antena conectada al APC220

### Conexión Arduino UNO ↔ APC220

```
Arduino UNO     APC220
───────────────────────
GND        →    GND
D13        →    VCC
D12        →    EN
D11        →    RXD
D10        →    TXD
D8         →    SET
```

### Pasos

1. Conecta el APC220 al Arduino UNO según el esquema
2. Conecta la antena al APC220
3. Carga el programa: `PROGRAMA_CONFIGURACION_APC220_CON_VERIFICACION.ino`
4. Abre Monitor Serie a 9600 baud
5. Verás la configuración actual
6. Para escribir nueva configuración: `WR 434000 3 9 3 0` (Cambiarla por la que den a cada equipo)
7. Para verificar: `RD`
8. Debe responder: `PARA 434000 3 9 3 0`
9. **REPITE con el segundo APC220**

---

## PARTE 2: CONEXIÓN PARA TELEMETRÍA

### ⚠️IMPORTANTE: 
/*  Usamos la conexión CRUZADA por defecto (D2 a TX y D3 a RX).
 * SI NO SE RECIBE NADA EN EL MONITOR SERIE:
 * - Poner la conexión DIRECTA (D2 con RX y D3 con TX).
 * Dependiendo de cómo esté etiquetado tu módulo APC220, 
 * funcionará de una forma o de la otra. COMPRUÉBALO SIEMPRE.
 *
 * ⚠️Cargar el programa CON LA ANTENA CONECTADA para evitar daños en el módulo.
 */

---

### Emisor: Arduino Nano 33 BLE Sense + APC220

```
Nano 33 BLE     APC220
───────────────────────
Pin D2 (RX)  →   RXD
Pin D3 (TX)  →   TXD
3.3V         →   VCC
GND          →   GND
```

**NOTA:** El pin EN puede dejarse sin conectar, funciona igualmente.  
Compatible con conector Grove (4 pines: VCC, GND, TX, RX).

Programa: `prueba_telemetria_emisor.ino`

---

### Receptor Opción A: Arduino UNO + APC220 (Recomendado)

Usa la misma conexión que para configurar. El Arduino controla los pines EN y VCC.

```
Arduino UNO     APC220
───────────────────────
GND        →    GND
D13        →    VCC
D12        →    EN
D11        →    RXD
D10        →    TXD
D8         →    SET
```

Programa: `prueba_telemetria_receptor.ino`

Abre el Monitor Serie a 9600 baud y verás los datos recibidos.

**Ventaja:** No hay que puentear nada, el programa controla EN.

---

### Receptor Opción B: USB-TTL + APC220

Conexión directa del APC220 al adaptador USB-TTL.

```
USB-TTL     APC220
───────────────────
TX      →   TXD
RX      →   RXD
3.3V    →   VCC
GND     →   GND
```

Abre el Monitor Serie del puerto USB-TTL a 9600 baud.

**Nota:** El pin EN del APC220 se deja sin conectar, funciona igualmente.

**IMPORTANTE:** El problema más común es cruzar las conexiones TX/RX. 

---

## VERIFICACIÓN

Ambos métodos de receptor fueron probados y funcionan correctamente.

1. Carga `prueba_telemetria_emisor.ino` en el Nano 33 BLE
2. Elige un método de receptor:
   - **Opción A:** Arduino UNO con `prueba_telemetria_receptor.ino`
   - **Opción B:** USB-TTL conectado al PC
3. Abre el Monitor Serie del receptor a 9600 baud
4. Deberías ver "HOLA" cada 2 segundos

---

## PROBLEMAS COMUNES

### No hay comunicación

El problema más común es **cruzar las conexiones TX/RX**.

1. **¿Conexiones directas?** → TX→TXD, RX→RXD 
2. **¿Misma configuración en ambos APC220?** → Verificar con `RD`
3. **¿Antenas conectadas?** 

### Error al configurar

1. ¿Antena conectada? → Módulo inestable sin antena
2. ¿Arduino UNO? → Nano 33 BLE no sirve para configurar (no soporta SoftwareSerial)

---

## CHECKLIST

```
CONFIGURACIÓN:
[ ] APC220 #1 configurado: PARA 434000 3 9 3 0
[ ] APC220 #2 configurado: PARA 434000 3 9 3 0

EMISOR (Nano 33 BLE):
[ ] Pin D2 → RXD
[ ] Pin D3 → TXD
[ ] 3.3V → VCC
[ ] GND → GND
[ ] Antena conectada

RECEPTOR:
[ ] Conexión correcta
[ ] Antena conectada
[ ] Monitor serie a 9600 baud

PRUEBA:
[ ] Receptor muestra "HOLA" cada 2 segundos
[ ] Listo para integrar sensores
```
