eloisaglez/caelum/(commit log)

2026-02-12 Create 📁 panel_control
2026-02-12 Update and rename caelum_ground_station.py to 🐍 caelum_ground_station.py
2026-02-12 Update and rename 🐍 caelum_ground_station.py to 🐍_caelum_ground_station.py
2026-02-12 Update and rename simulador_dashboard.py to 🐍_simulador_dashboard.py
2026-02-12 Update and rename caelum_dashboard.html to 🌐_caelum_dashboard.html
2026-02-12 Update and rename 🌐_caelum_dashboard.html to 🌐_dashboard_caelum.html
2026-02-12 Update and rename 🐍_simulador_dashboard.py to 🐍_caelum_playback.py
2026-02-12 Update and rename 🐍_caelum_ground_station.py to 🐍_datos_puerto_serie.py
2026-02-12 Update and rename cargar_datos_vuelo.py to 🐍_cargar_datos_vuelo.py
2026-02-13 Update and rename 🐍_datos_puerto_serie.py to 🐍_receptor_telemetria.py
2026-02-13 Update and rename 🐍_caelum_playback.py to 🐍_caelum_playback_colab.py
2026-02-13 Update and rename 🐍_caelum_playback_colab.py to 🐍_caelum_playback.py
2026-02-13 Update and rename dashboard_caelum.html to 🌐_dashboard_caelum.html
2026-02-13 Update and rename 🌐_dashboard_caelum.html to 🌐_caelum_dashboard.html
2026-03-18 Fix CSV structure comment to reflect 26 columns
    [CANSAT_VUELO_INTEGRADO.ino]
