eloisaglez/caelum/(notices)

Notices in the files:
README_main.md:
License: Educational
